singharyan2001/HWE-Isolated-USB-to-UART-Design/HWE-Isolated-USB-to-UART-Design.kicad_pcb

## KiCad design HWE-Isolated-USB-to-UART-Design.kicad_pcb (2026-08-03)

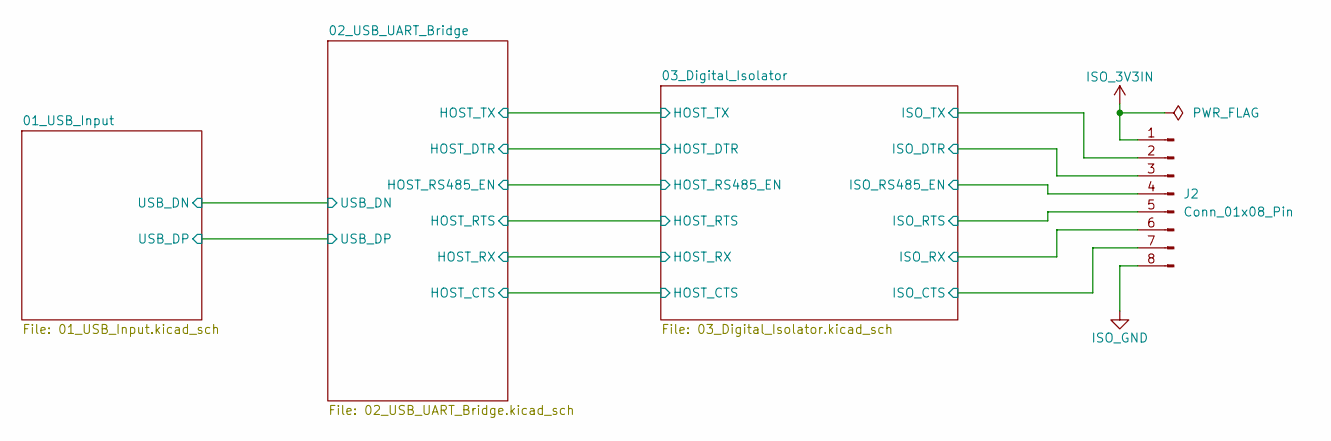
[picture p1: schematic HWE-Isolated-USB-to-UART-Design.kicad_sch, Isolated USB to UART Module Design]

Parts:
J2: Conn_01x08_Pin; PinHeader_1x08_P2.54mm_Horizontal

Connections:
/03_Digital_Isolator/ISO_CTS: J2.7; also elsewhere on the board
/03_Digital_Isolator/ISO_DTR: J2.3; also elsewhere on the board
/03_Digital_Isolator/ISO_RS485_EN: J2.4; also elsewhere on the board
/03_Digital_Isolator/ISO_RTS: J2.5; also elsewhere on the board
/03_Digital_Isolator/ISO_RX: J2.6; also elsewhere on the board
/03_Digital_Isolator/ISO_TX: J2.2; also elsewhere on the board
ISO_3V3IN: J2.1
ISO_GND: J2.8; also elsewhere on the board

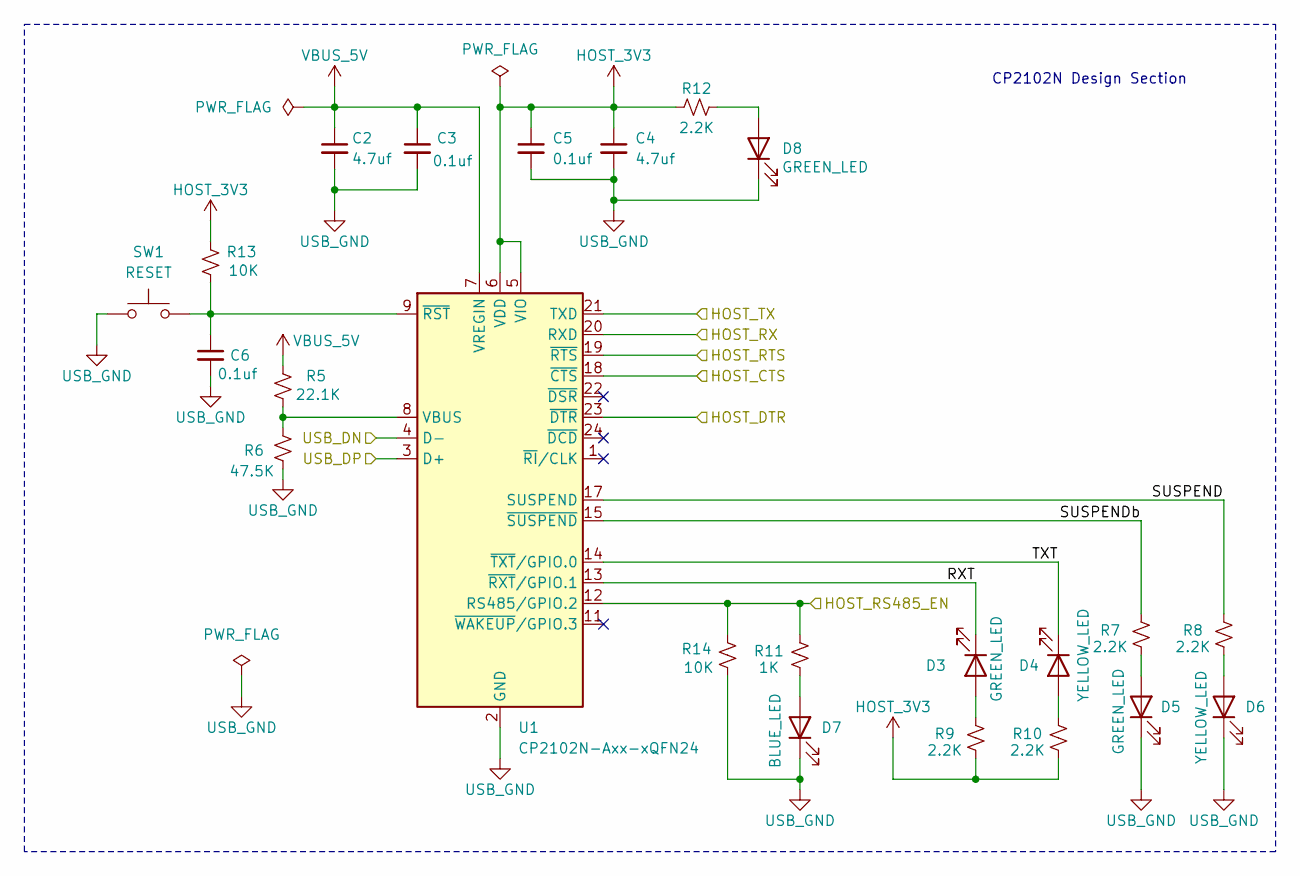
[picture p2: schematic 02_USB_UART_Bridge.kicad_sch]

Parts:
C2, C4: 4.7uf; C_0805_2012Metric_Pad1.18x1.45mm_HandSolder
C3, C5, C6: 0.1uf; C_0805_2012Metric_Pad1.18x1.45mm_HandSolder
D3, D5, D8: GREEN_LED; LED_0805_2012Metric_Pad1.15x1.40mm_HandSolder
D4, D6: YELLOW_LED; LED_0805_2012Metric_Pad1.15x1.40mm_HandSolder
D7: BLUE_LED; LED_0805_2012Metric_Pad1.15x1.40mm_HandSolder
R5: 22.1K; R_0805_2012Metric_Pad1.20x1.40mm_HandSolder
R6: 47.5K; R_0805_2012Metric_Pad1.20x1.40mm_HandSolder
R7, R8, R9, R10, R12: 2.2K; R_0805_2012Metric_Pad1.20x1.40mm_HandSolder
R11: 1K; R_0805_2012Metric_Pad1.20x1.40mm_HandSolder
R13, R14: 10K; R_0805_2012Metric_Pad1.20x1.40mm_HandSolder
SW1: RESET; SW_SPST_CK_RS282G05A3
U1: CP2102N-Axx-xQFN24; QFN-24-1EP_4x4mm_P0.5mm_EP2.6x2.6mm_ThermalVias

Connections:
/01_USB_Input/USB_DN: U1.4 (D-); also elsewhere on the board
/01_USB_Input/USB_DP: U1.3 (D+); also elsewhere on the board
/02_USB_UART_Bridge/HOST_CTS: U1.18 (~CTS); also elsewhere on the board
/02_USB_UART_Bridge/HOST_DTR: U1.23 (~DTR); also elsewhere on the board
/02_USB_UART_Bridge/HOST_RS485_EN: R11.1, R14.2, U1.12 (RS485/GPIO.2); also elsewhere on the board
/02_USB_UART_Bridge/HOST_RTS: U1.19 (~RTS); also elsewhere on the board
/02_USB_UART_Bridge/HOST_RX: U1.20 (RXD); also elsewhere on the board
/02_USB_UART_Bridge/HOST_TX: U1.21 (TXD); also elsewhere on the board
/02_USB_UART_Bridge/RXT: D3.1 (K), U1.13 (~RXT/GPIO.1)
/02_USB_UART_Bridge/SUSPEND: R8.1, U1.17 (SUSPEND)
/02_USB_UART_Bridge/SUSPENDb: R7.1, U1.15 (~SUSPEND)
/02_USB_UART_Bridge/TXT: D4.1 (K), U1.14 (~TXT/GPIO.0)
HOST_3V3: C4.1, C5.1, R9.2, R10.2, R12.1, R13.1, U1.5 (VIO), U1.6 (VDD); also elsewhere on the board
unnamed: D3.2 (A), R9.1
unnamed: D4.2 (A), R10.1
unnamed: D5.2 (A), R7.2
unnamed: D6.2 (A), R8.2
unnamed: D7.2 (A), R11.2
unnamed: D8.2 (A), R12.2
unnamed: R5.2, R6.1, U1.8 (VBUS)
unnamed: C6.1, R13.2, SW1.2, U1.9 (~RST)
USB_GND: C2.2, C3.2, C4.2, C5.2, C6.2, D5.1 (K), D6.1 (K), D7.1 (K), D8.1 (K), R6.2, R14.1, SW1.1, U1.2 (GND), U1.25 (GND); also elsewhere on the board
VBUS_5V: C2.1, C3.1, R5.1, U1.7 (VREGIN); also elsewhere on the board

Notes on the sheet:
CP2102N Design Section

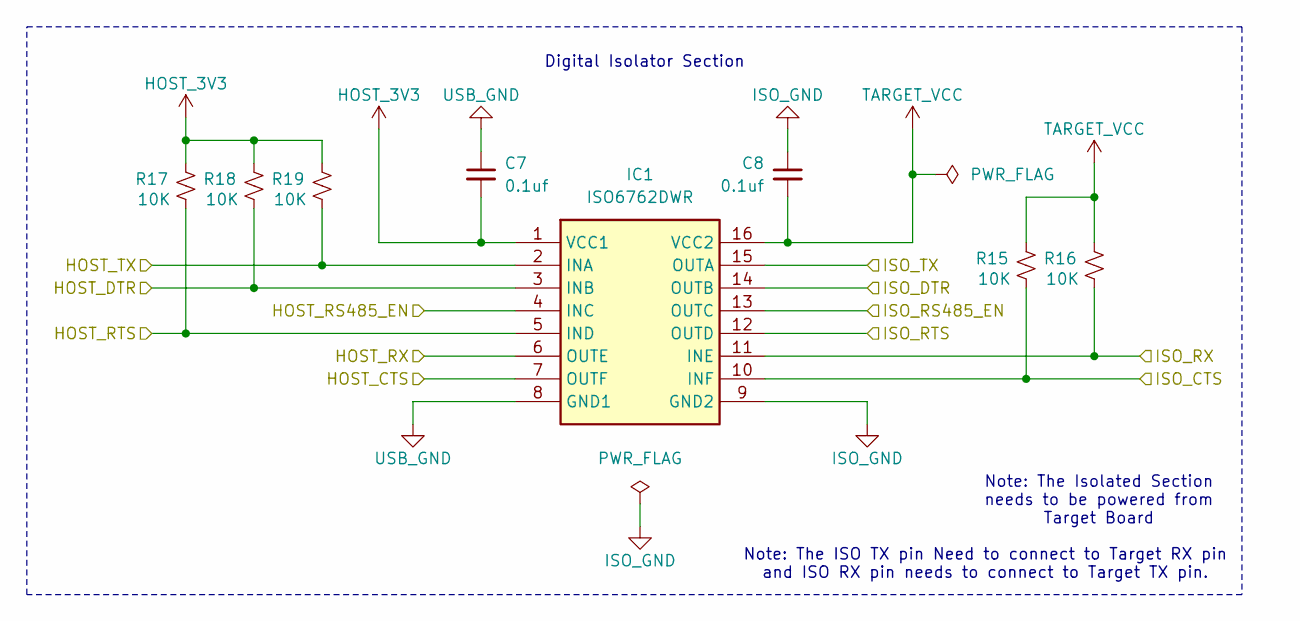
[picture p3: schematic 03_Digital_Isolator.kicad_sch]

Parts:
C7, C8: 0.1uf; C_0805_2012Metric_Pad1.18x1.45mm_HandSolder
IC1: ISO6762DWR; SOIC127P1030X265-16N; Mouser Part Number 595-ISO6762DWR
R15, R16, R17, R18, R19: 10K; R_0805_2012Metric_Pad1.20x1.40mm_HandSolder

Connections:
/02_USB_UART_Bridge/HOST_CTS: IC1.7 (OUTF); also elsewhere on the board
/02_USB_UART_Bridge/HOST_DTR: IC1.3 (INB), R18.1; also elsewhere on the board
/02_USB_UART_Bridge/HOST_RS485_EN: IC1.4 (INC); also elsewhere on the board
/02_USB_UART_Bridge/HOST_RTS: IC1.5 (IND), R17.1; also elsewhere on the board
/02_USB_UART_Bridge/HOST_RX: IC1.6 (OUTE); also elsewhere on the board
/02_USB_UART_Bridge/HOST_TX: IC1.2 (INA), R19.1; also elsewhere on the board
/03_Digital_Isolator/ISO_CTS: IC1.10 (INF), R15.1; also elsewhere on the board
/03_Digital_Isolator/ISO_DTR: IC1.14 (OUTB); also elsewhere on the board
/03_Digital_Isolator/ISO_RS485_EN: IC1.13 (OUTC); also elsewhere on the board
/03_Digital_Isolator/ISO_RTS: IC1.12 (OUTD); also elsewhere on the board
/03_Digital_Isolator/ISO_RX: IC1.11 (INE), R16.1; also elsewhere on the board
/03_Digital_Isolator/ISO_TX: IC1.15 (OUTA); also elsewhere on the board
HOST_3V3: C7.2, IC1.1 (VCC1), R17.2, R18.2, R19.2; also elsewhere on the board
ISO_GND: C8.1, IC1.9 (GND2); also elsewhere on the board
TARGET_VCC: C8.2, IC1.16 (VCC2), R15.2, R16.2
USB_GND: C7.1, IC1.8 (GND1); also elsewhere on the board

Notes on the sheet:
Note: The ISO TX pin Need to connect to Target RX pin and ISO RX pin needs to connect to Target TX pin.
Note: The Isolated Section needs to be powered from Target Board
Digital Isolator Section

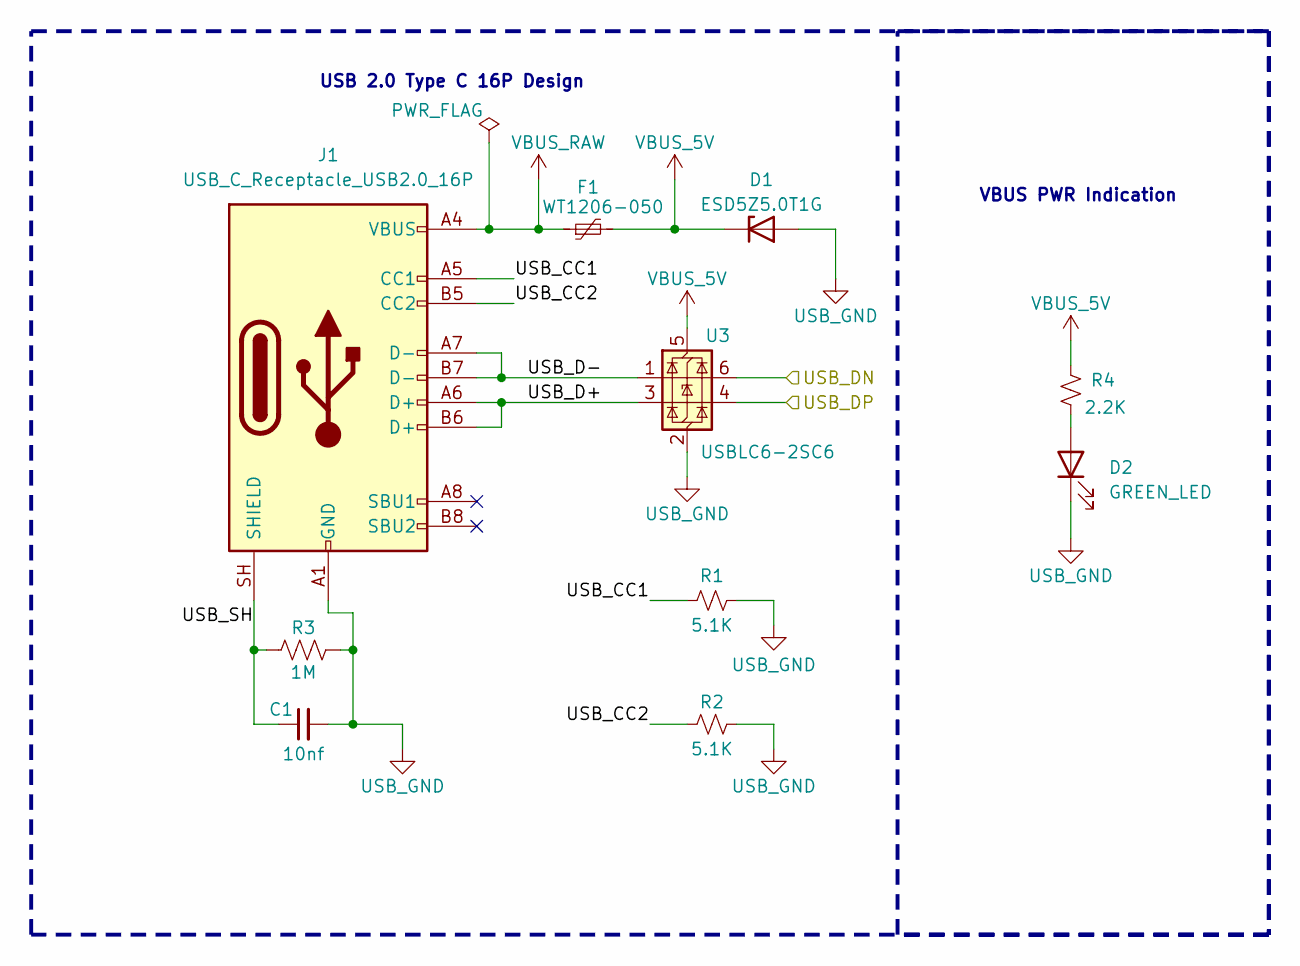
[picture p4: schematic 01_USB_Input.kicad_sch, Isolated USB to UART Module Design]

Parts:
C1: 10nf; C_0805_2012Metric_Pad1.18x1.45mm_HandSolder
D1: ESD5Z5.0T1G; D_SOD-523
D2: GREEN_LED; LED_0805_2012Metric_Pad1.15x1.40mm_HandSolder
F1: WT1206-050; Fuse_1206_3216Metric_Pad1.42x1.75mm_HandSolder
J1: USB_C_Receptacle_USB2.0_16P; USB_C_Receptacle_HRO_TYPE-C-31-M-12
R1, R2: 5.1K; R_0805_2012Metric_Pad1.20x1.40mm_HandSolder
R3: 1M; R_1206_3216Metric_Pad1.30x1.75mm_HandSolder
R4: 2.2K; R_0805_2012Metric_Pad1.20x1.40mm_HandSolder
U3: USBLC6-2SC6; SOT-23-6_Handsoldering

Connections:
/01_USB_Input/USB_CC1: J1.A5 (CC1), R1.2
/01_USB_Input/USB_CC2: J1.B5 (CC2), R2.2
/01_USB_Input/USB_D+: J1.A6 (D+), J1.B6 (D+), U3.3 (I/O2)
/01_USB_Input/USB_D-: J1.A7 (D-), J1.B7 (D-), U3.1 (I/O1)
/01_USB_Input/USB_DN: U3.6 (I/O1); also elsewhere on the board
/01_USB_Input/USB_DP: U3.4 (I/O2); also elsewhere on the board
/01_USB_Input/USB_SH: C1.1, J1.SH (SHIELD), R3.2
unnamed: D2.2 (A), R4.1
USB_GND: C1.2, D1.2 (A), D2.1 (K), J1.A1 (GND), J1.A12 (GND), J1.B1 (GND), J1.B12 (GND), R1.1, R2.1, R3.1, U3.2 (GND); also elsewhere on the board
VBUS_5V: D1.1 (K), F1.2, R4.2, U3.5 (VBUS); also elsewhere on the board
VBUS_RAW: F1.1, J1.A4 (VBUS), J1.A9 (VBUS), J1.B4 (VBUS), J1.B9 (VBUS)

Notes on the sheet:
USB 2.0 Type C 16P Design
VBUS PWR Indication

Board: 2 copper layers, 42 parts (0 on the bottom side), 38 nets, no tracks yet.
