singharyan2001/HWE-Isolated-USB-to-UART-Design/(commit log)

2026-07-29 init commit
    [HWE-Isolated-USB-to-UART-Design.kicad_pcb, HWE-Isolated-USB-to-UART-Design.kicad_sch]
2026-07-31 Research Phase 85% done, with USB Type C, USB-to-UART IC, and Digital Isolator Researched & Selected, but will close eevrything once validated everything by going through datasheets of the component 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
    [HWE-Isolated-USB-to-UART-Design.kicad_sch]
2026-08-01 deep diving into the component datasheets for USB Type C Connector and USB UART IC -WIP
    [HWE-Isolated-USB-to-UART-Design.kicad_sch]
2026-08-02 Currently in Schematic Design phase, just finished with draft usb c design, and now setup done for SP2102N & Digital Isolator Section
    [01_USB_Input.kicad_sch, 02_USB_UART_Bridge.kicad_sch, 03_Digital_Isolator.kicad_sch, HWE-Isolated-USB-to-UART-Design.kicad_pcb, HWE-Isolated-USB-to-UART-Design.kicad_sch]
2026-08-03 completed schematic design, and selected all footprints and for now will go for 0805 for resistors, capacitors and leds - will later make a call during layoting
    [01_USB_Input.kicad_sch, 02_USB_UART_Bridge.kicad_sch, 03_Digital_Isolator.kicad_sch, HWE-Isolated-USB-to-UART-Design.kicad_pcb, HWE-Isolated-USB-to-UART-Design.kicad_sch]
2026-08-03 Review draft schematics and BOM was also generated, now will move to pcb design phase
    [HWE-Isolated-USB-to-UART-Design.kicad_sch]
